brunoosz/Festo2026/README.md

<div align="center">

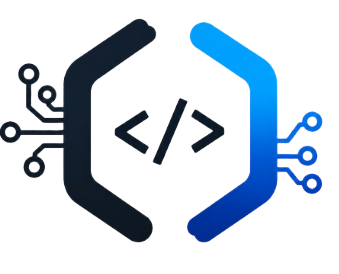
[picture p1: public/logo.png]
Dark Coders


# Flow Pack: Sistema de Controle

Aplicação web para operar e monitorar uma máquina de embalagem Flow Pack em tempo real.






</div>

<p align="center">
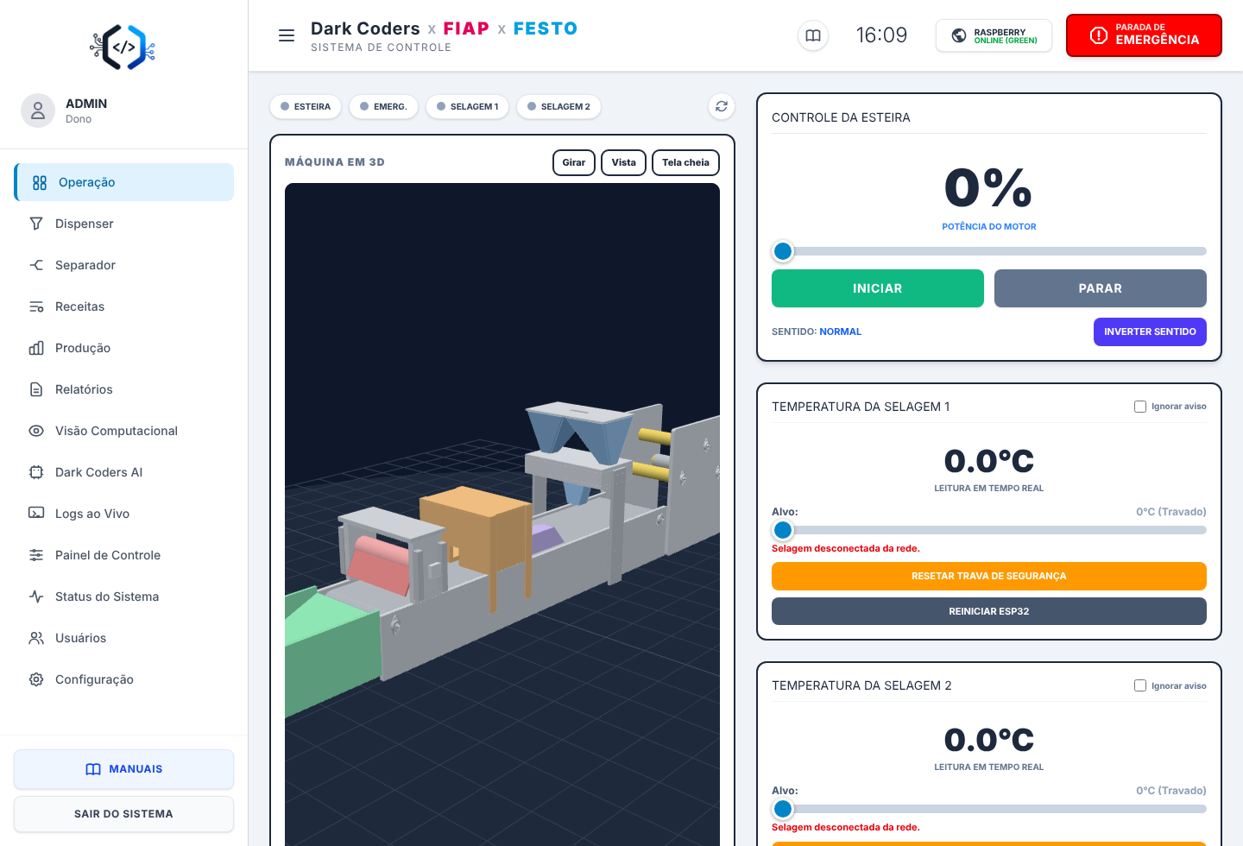
[picture p2: docs/img/dashboard.png]
Tela de operação do sistema
  
</p>

## Visão geral

Projeto da equipe **Dark Coders** (Engenharia da Computação, FIAP) para a **Festo 2026**. O sistema roda em um Raspberry Pi, que se comunica por MQTT com os ESP32 de cada módulo da máquina e entrega uma interface web para operação, acompanhamento da produção e manutenção.

A linha de embalagem é composta por esteira, bobina de filme, dispenser, braço formador, selagem horizontal, selagem final e separador de itens. Cada módulo tem controle individual, indicador de conexão e registro de eventos.

## Funcionalidades

| Módulo | Descrição |
|---|---|
| Operação | Velocidade da esteira, temperatura das selagens, modelo 3D da máquina e LEDs de conexão de **todas as placas** (esteira, selagens, rodinhas, motor, dispenser, servo, câmera e painel NFC). O topo do site mostra sempre a **receita selecionada** (50, 100, 150 ou 200 g). |
| Painel de Controle | Motores e aquecimento de cada selagem, sentido da esteira, reinício e reset de cada placa. Tem também a seção **Separador (servo)**: estado da conexão, teste esquerda/centro/direita, ângulos, velocidade, tempo aberto e liga/desliga do servo (somente Administrador e Dono). |
| Dispenser | Seleção do grão e da quantidade (1/4, 1/2, 3/4 ou 1 volta do rotor) e acionamento da dosagem. |
| Separador | Contagem e reconhecimento de produtos por câmera, com servo que desvia cada item. Inclui treinamento por classe e calibração de fundo, e o **Controle livre do servo** (funciona sem câmera): modo Automático/Manual, ângulo 0–180° ao vivo, esquerda/centro/direita, velocidade, voltar ao centro sozinho, calibração com limites e pulsos, presets, sequências e simulação de detecção. Dono, Adm e Operário comandam; Visualizador só vê. |
| Visão Computacional | Zona de detecção, produtos de referência e confirmação por IA. A câmera mostra o que a IA lê, igual ao Separador: linha de contagem, caixas numeradas (amarela = acompanhando, verde = contada) e nome do produto com a confiança em %. |
| Receitas | Níveis de 50, 100, 150 e 200 g com velocidade e temperatura predefinidas. |
| Produção e Relatórios | Gráficos por hora e por dia e exportação de relatórios em PDF. |
| Dark Coders AI | Assistente com base de conhecimento local e IA online opcional. Aceita comandos por texto e por voz. |
| Alexa | Skill própria: liga com a receita de 50, 100, 150 ou 200 g, aciona a parada de emergência e troca de receita por voz (aumentar, diminuir, escolher e perguntar). |
| Logs ao Vivo | Registro em tempo real de tudo o que acontece, com usuário e origem (site, assistente ou Alexa). |
| Status do Sistema | Internet, Raspberry (temperatura, memória, alimentação) e conexão de cada dispositivo. |
| Usuários | Quatro níveis de acesso e permissão de telas por usuário. |
| Cartões NFC | Cadastro de cartões de Dono/Administrador que liberam a emergência e os botões do painel. |
| Manuais | Manuais em PDF de cada módulo e da máquina completa. |

<p align="center">
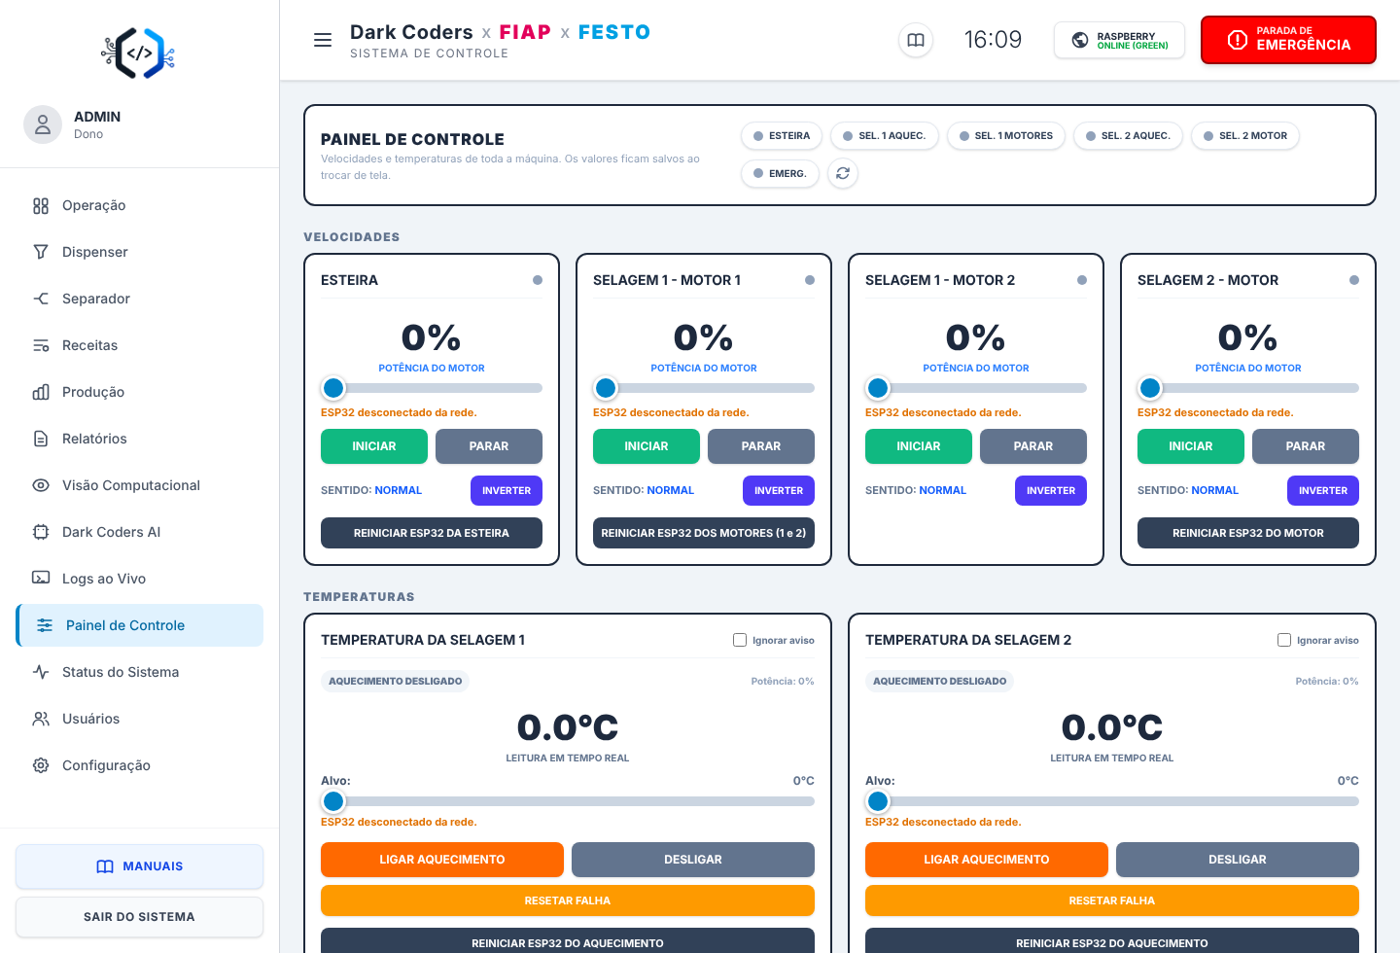
[picture p3: docs/img/painel-controle.png]
Painel de Controle
  
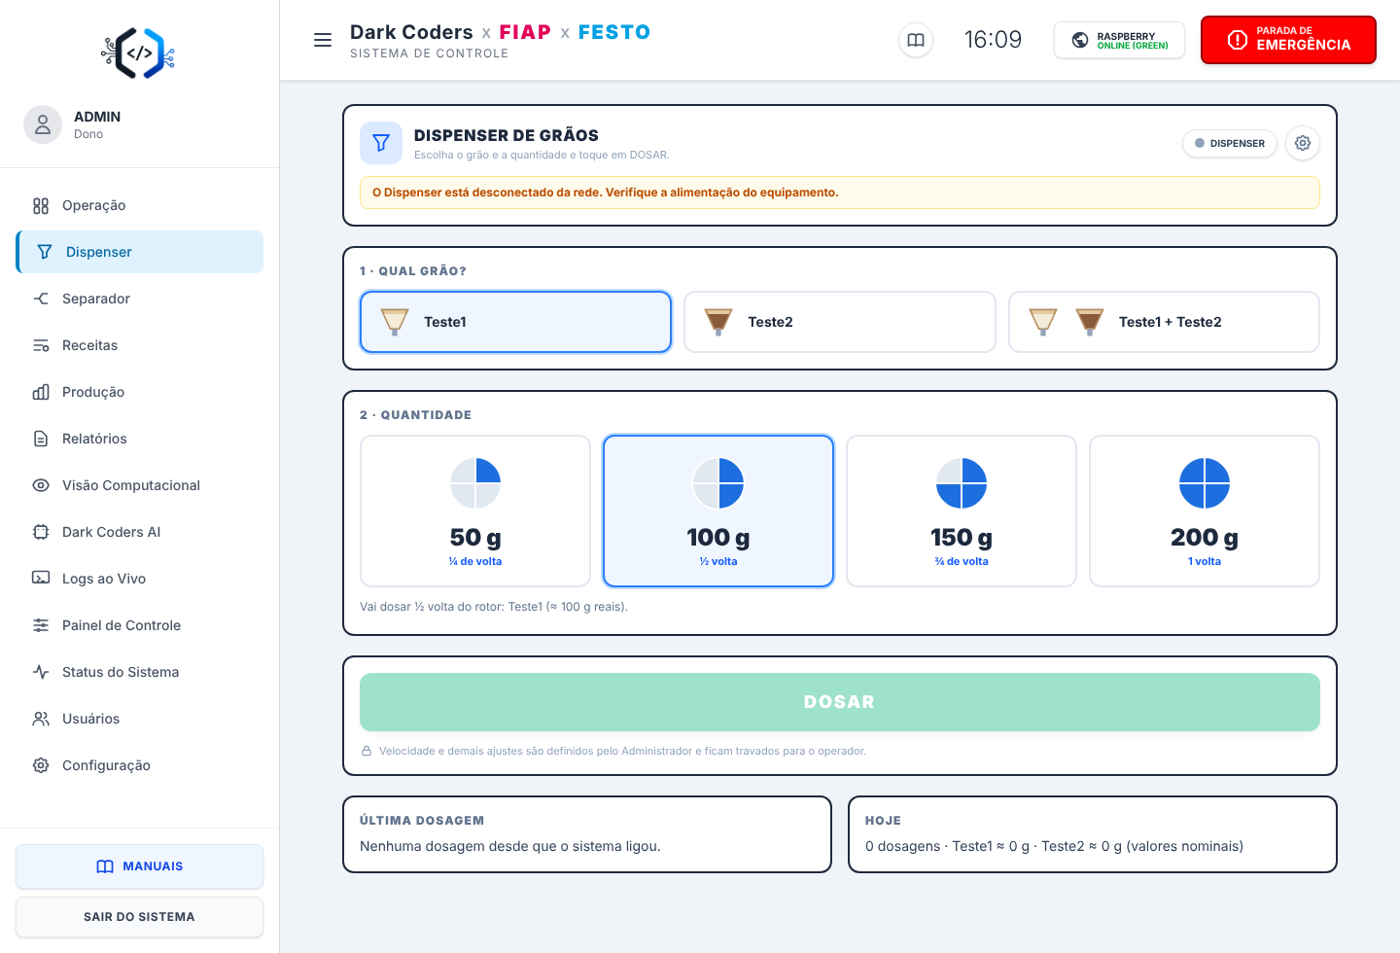
[picture p4: docs/img/dispenser.png]
Dispenser
  
</p>
<p align="center">
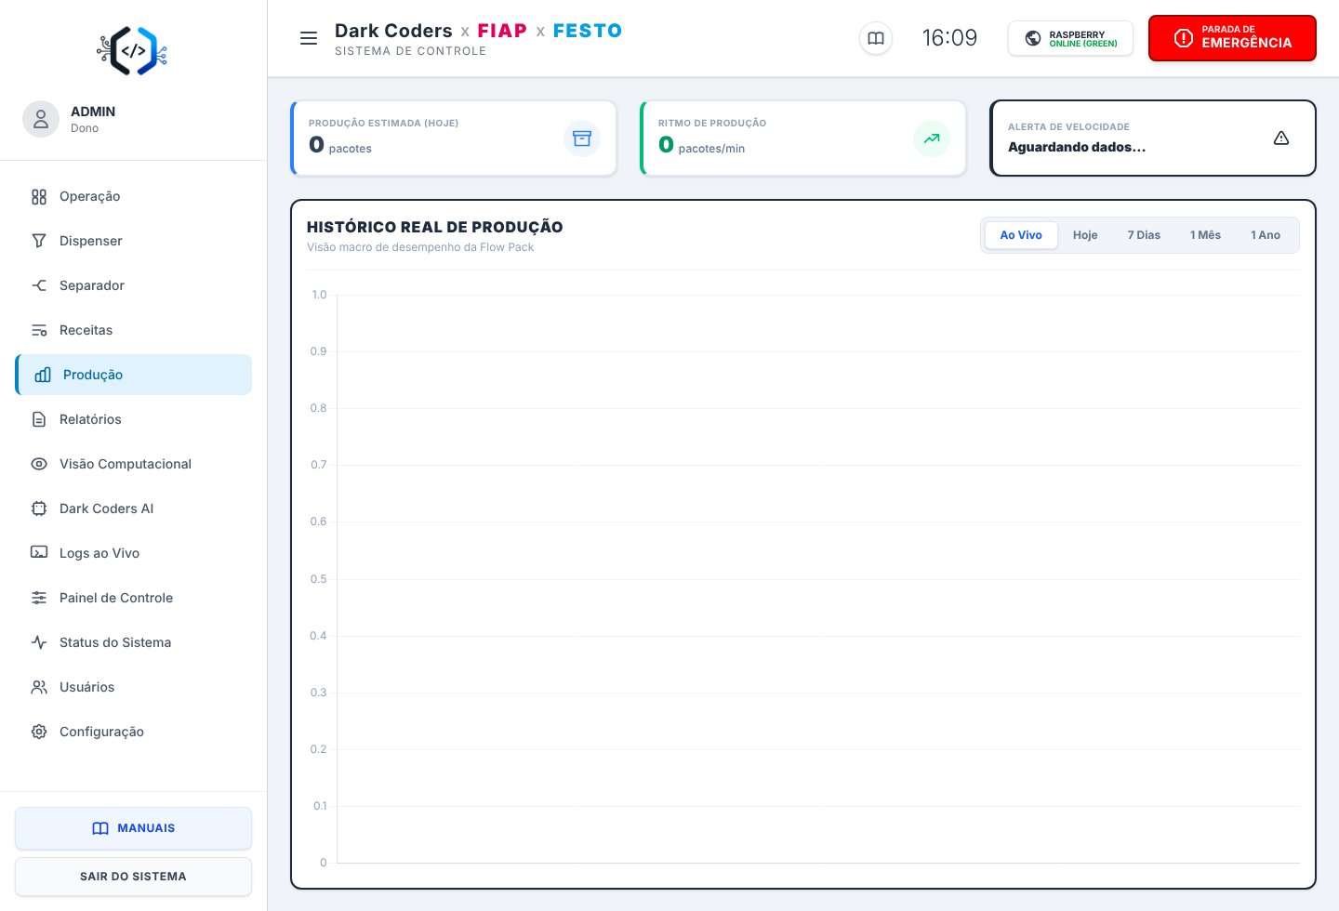
[picture p5: docs/img/producao.png]
Produção
  
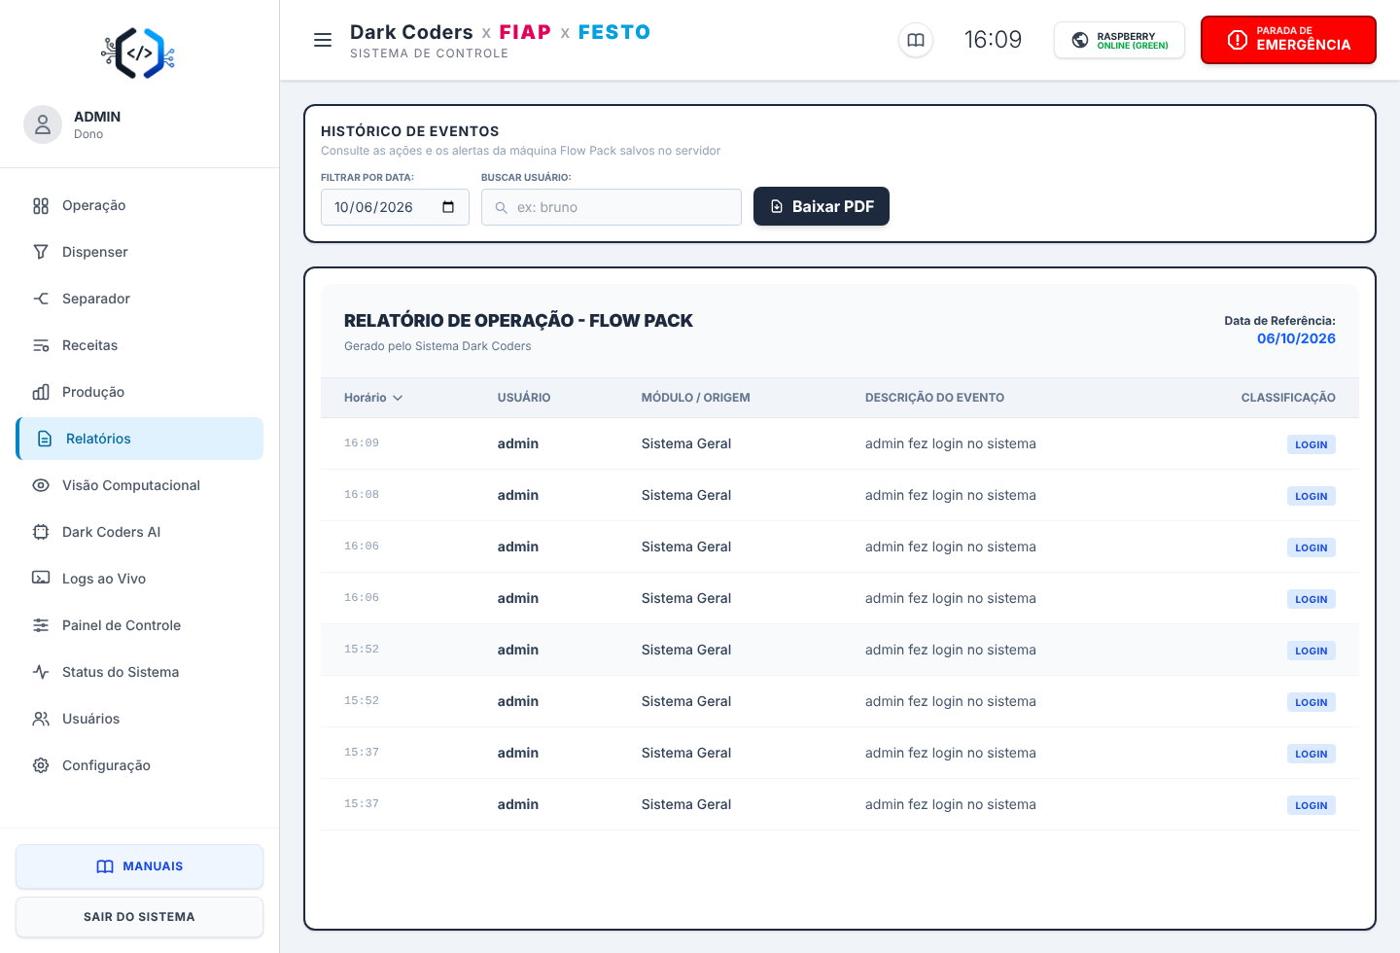
[picture p6: docs/img/relatorios.png]
Relatórios
  
</p>
<p align="center">
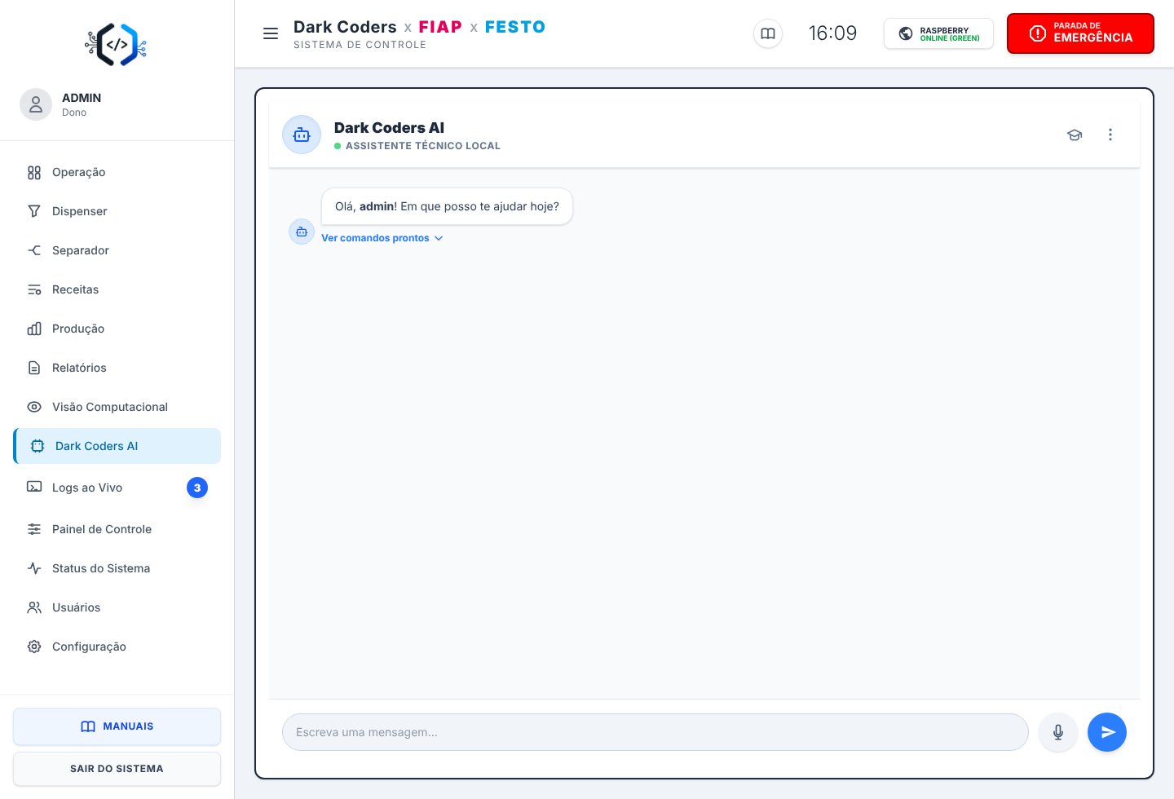
[picture p7: docs/img/chat.png]
Dark Coders AI
  
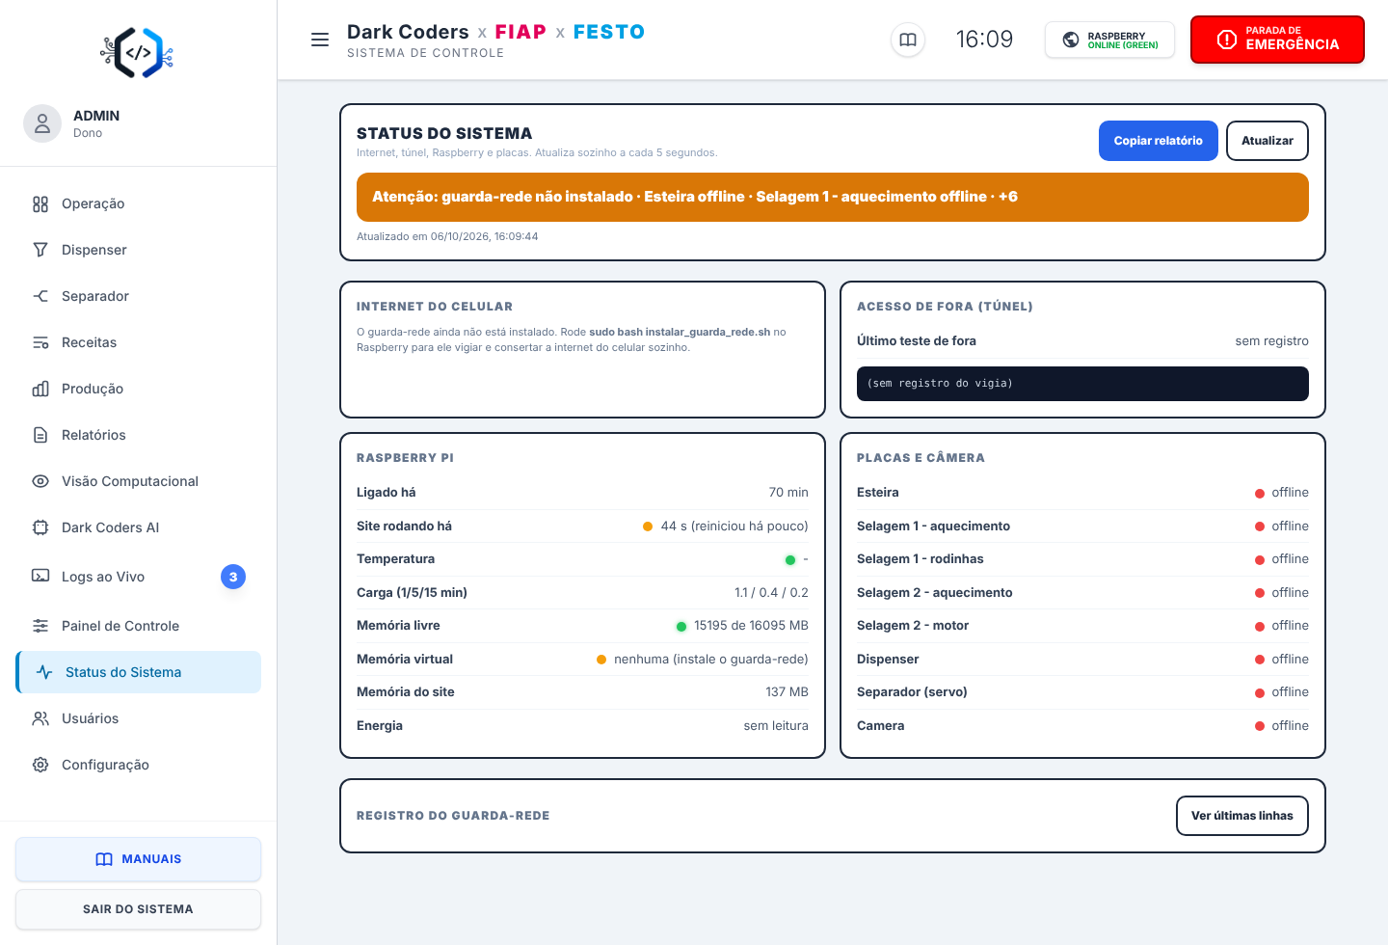
[picture p8: docs/img/status-sistema.png]
Status do Sistema
  
</p>

### Parada de emergência

- O botão fica visível em **todas as telas**, e a emergência também pode vir do botão da esteira, do botão do painel ou da Alexa.
- Depois de acionada, **a máquina inteira fica travada** (esteira, selagens, dispenser, separador, receitas e botões MAIS/MENOS) até um **Dono ou Administrador** liberar.
- Liberar: botão **DESBLOQUEAR** no site (com confirmação) ou **cartão NFC** cadastrado. Depois de liberar, a esteira continua parada.
- A trava vale para todos os aparelhos, continua se o servidor reiniciar. A trava vive só no site: as placas apenas param (a esteira gira ao contrário por 1 s e o servo vai ao centro) e não guardam trava, então liberar no site libera tudo na hora.
- Com a emergência ativa, **todas as telas ganham uma borda vermelha brilhando** (some sozinha ao liberar).

### Cartão NFC e painel físico

Um ESP32 só para o painel (leitor RC522 ou PN532, buzzer, LEDs e 3 botões: EMERGÊNCIA, MAIS e MENOS) manda o número do cartão por MQTT (`nfc/leitura`) e o **servidor decide** (`nfc/resultado`).

- Cartão de **Dono ou Administrador**: libera a emergência (se ativa) e libera **MAIS** e **MENOS** por 30 s, com o LED verde aceso (cada uso renova; variável `NFC_JANELA_MS`).
- A **EMERGÊNCIA** do painel vale sempre, com ou sem cartão. MAIS e MENOS sem cartão não fazem nada (1 bip médio).
- 3 cartões recusados seguidos bloqueiam o leitor por 30 s. Sem Wi-Fi ou site, nada é liberado.
- Só o **Dono** cadastra e apaga cartões, na tela **Cartões NFC** (`/nfc`); a tela mostra só o final de 4 dígitos.
- Desbloquear a emergência pelo site exige Dono ou Administrador.
- Limite: o número do cartão pode ser copiado por cartões "mágicos"; serve ao projeto, não é segurança forte.

Firmwares em [`firmware/`](firmware) e montagem em [`docs/hardware/guia_painel_nfc.txt`](docs/hardware/guia_painel_nfc.txt).

<p align="center">
  Tela Cartões NFC
</p>

### Página pública Sobre nós

[`/sobre`](views/sobre.html) abre **sem login** (botão "i" ao lado de Manuais, item do menu no celular e link na tela de login).

- Menu fixo com as seções: quem somos, o projeto (com galeria), a equipe (cartões com contatos), a jornada e o contato.
- A ordem e a visibilidade das seções e das pessoas vêm dos dados; cada pessoa só mostra e-mail, telefone e links se estiver com "mostrar contatos" ligado e preenchido. Sem foto, aparecem as iniciais.
- O texto original fica em [`data/sobre.json`](data/sobre.json). As alterações salvas ficam em `data/sobre_editado.json` (fora do git, para o `git pull` nunca dar conflito), as fotos em `public/img/equipe/` e `public/img/projeto/`, e os 10 últimos backups em `data/sobre_backups/`. Para voltar a uma versão antiga na mão, copie um backup por cima de `data/sobre_editado.json` e reinicie o site.
- Ícones dos links em SVG local (`sobre_icones.json`) e todo texto escapado na saída.

<p align="center">
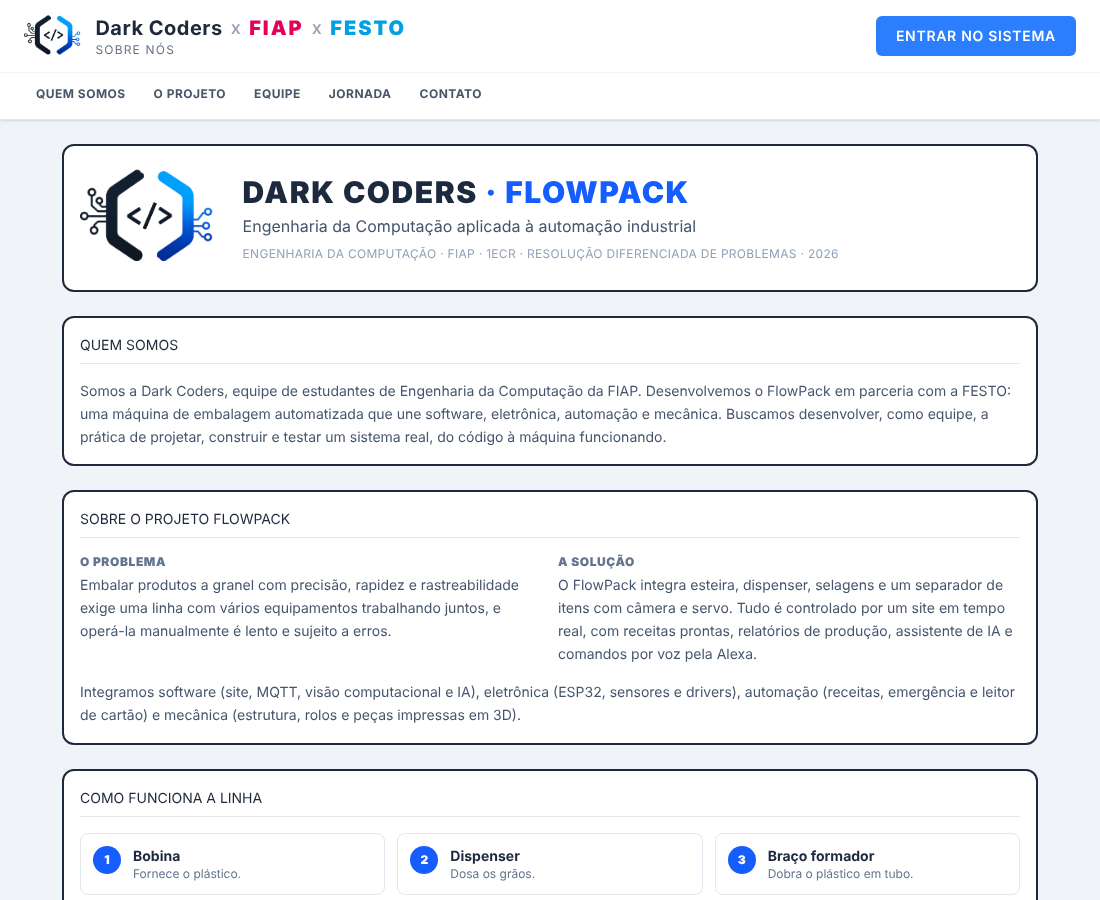
[picture p9: docs/img/sobre.png]
Página Sobre nós
  
</p>

### Modelo 3D

A máquina pode ser visualizada em 3D no próprio site (Dashboard e tela Modelo 3D), com rotação, zoom e modo estrutura. O visualizador usa Three.js com os arquivos servidos localmente, então funciona sem internet. O modelo fica em [`public/modelo/maquina.glb`](public/modelo); para trocá-lo, basta substituir o arquivo.

<p align="center">
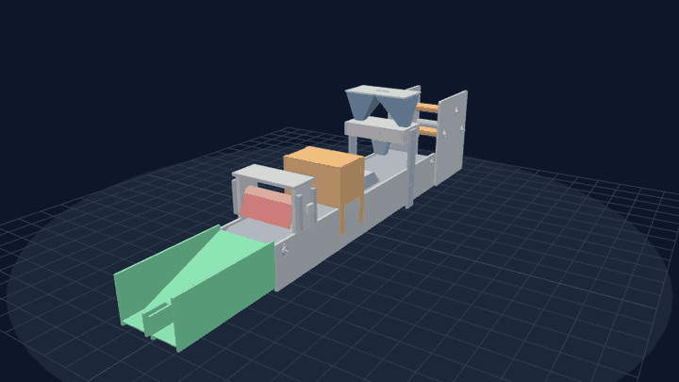
[picture p10: docs/img/modelo-3d.gif]
Modelo 3D da máquina girando
  
</p>

## Arquitetura

<p align="center">
  Diagrama de arquitetura
</p>

- **Back-end:** Node.js, Express 5, Socket.IO e Nunjucks.
- **Front-end:** HTML e JavaScript, Tailwind CSS, Chart.js, jsPDF e Three.js, todos servidos localmente.
- **Mensageria:** MQTT, com o broker Mosquitto no próprio Raspberry.
- **Persistência:** arquivos JSON e a pasta `logs/`. Não há banco de dados, o que mantém o consumo baixo para o Raspberry Pi 3B+.
- **IA:** busca por similaridade na base local (`knowledge/`) e, opcionalmente, modelos da NVIDIA para o chat e a visão.

### Tópicos MQTT

| Módulo | Tópicos |
|---|---|
| Esteira | `esteira/velocidade/set`, `esteira/velocidade/atual`, `esteira/sentido/set`, `esteira/sentido/atual`, `esteira/status`, `esteira/emergencia` |
| Selagem 1 | `selagem/set_temperatura`, `selagem/ativar`, `selagem/dados`, `selagem/status_conexao`, `selagem/emergencia`, `selagem/motores/status` |
| Selagem 2 | `selagem2/set_temperatura`, `selagem2/ativar`, `selagem2/dados`, `selagem2/status_conexao`, `selagem2/emergencia`, `selagem2/motor/status` |
| Dispenser | `dispenser/dosar`, `dispenser/estado`, `dispenser/concluido`, `dispenser/status`, `dispenser/reiniciar`, `dispenser/emergencia` |
| Separador | `separador/desviar`, `separador/config`, `separador/estado`, `separador/status`, `separador/teste`, `separador/emergencia`, `separador/liberar` |
| Emergência e painel | `esteira/botao`, `esteira/estado_emergencia`, `esteira/liberar`, `painel/botao`, `painel/resultado` |
| Cartão NFC | `nfc/leitura`, `nfc/resultado`, `nfc/status`, `nfc/reiniciar` |

## Instalação

### Requisitos

- Node.js 20.6 ou superior
- Broker MQTT acessível (por exemplo, Mosquitto)
- ESP32 dos módulos (opcional para apenas visualizar a interface)

### Passos

```bash
git clone https://github.com/brunoosz/Festo2026.git
cd Festo2026
npm install
cp .env.example .env
npm start
```

A aplicação fica disponível em `http://localhost:5000`. A porta e o endereço do broker podem ser trocados pelas variáveis `PORT` e `MQTT_BROKER` (tabela abaixo).

Na primeira execução, caso não exista `usuarios.json`, é criado o usuário `admin` com senha `admin`. **Altere a senha em Configuração antes de qualquer uso real.**

### Testando no seu computador (preview)

Não precisa do Raspberry nem das placas. Em dois terminais:

```bash
npm install
npm run mock   # broker MQTT de mentira com placas falsas (inclui o servo do separador)
npm run dev    # o site, em http://localhost:5000
```

O `dev` usa a pasta `data-teste/` (nada do `usuarios.json` real é tocado) e cria os logins `dono`, `adm`, `operario` e `visualizador`, todos com a senha `1234`. Para rodar os testes automáticos: `npm test`.

### Testes automáticos

`npm test` sobe o site com um broker MQTT falso e confere, de ponta a ponta: emergência travada, cartão NFC e botões do painel, perfis e permissões (inclusive o Visualizador), servo e visão, Alexa, página Sobre nós, manuais, modelo 3D, receita e LEDs no topo do Dashboard. Os testes ficam em [`tools/testes/`](tools/testes).

### Variáveis de ambiente

| Variável | Descrição | Obrigatória |
|---|---|---|
| `NVIDIA_API_KEY` | Chave da API NVIDIA para o chat e a visão por IA. Sem ela, o chat responde apenas com a base local. | Não |
| `SESSION_SECRET` | Segredo das sessões e dos cookies. Se ausente, é gerado e salvo em `.session_secret`. | Não |
| `MQTT_BROKER` | Endereço do broker MQTT. Padrão: `mqtt://192.168.4.1`. | Não |
| `PORT` | Porta do site. Padrão: `5000`. | Não |
| `NFC_JANELA_MS` | Tempo, em ms, que MAIS e MENOS ficam liberados depois de um cartão. Padrão: `30000` (mantenha igual ao `JANELA_MS` do firmware do painel). | Não |
| `USUARIOS_JSON`, `EMERGENCIA_JSON`, `RECEITAS_JSON`, `CARTOES_NFC_JSON` | Caminho dos arquivos de dados, para testes ou para guardar fora da pasta do site. Padrão: arquivos na pasta do projeto. | Não |

Para que o Node leia o `.env` automaticamente, use `npm run start:env`.

## Implantação no Raspberry Pi

### Atualização

Com o repositório já clonado em `/root/site_esteira` (serviço `site_esteira`), o jeito mais simples é:

```bash
cd /root/site_esteira && git checkout main && git pull
sudo systemctl restart site_esteira
journalctl -u site_esteira -n 30 --no-pager
```

Depois, `Ctrl+Shift+R` no navegador. Rode `npm install` só se o `package.json` tiver mudado. Os firmwares dos ESP32 são gravados pelo Arduino IDE (veja [`firmware/LEIA-ME.md`](firmware/LEIA-ME.md)).

Outra opção é o script abaixo, que também faz backup dos dados.

O script [`atualizar.sh`](atualizar.sh) baixa a versão mais recente do GitHub preservando os dados da máquina: `usuarios.json`, receitas, fotos de referência, configurações, `.env` e logs. Em seguida instala as dependências e reinicia o serviço (pm2 ou systemd).

```bash
cd ~/site_esteira && git fetch origin main && git checkout origin/main -- atualizar.sh && bash atualizar.sh
```

Antes de qualquer alteração, uma cópia dos dados é salva em `../festo2026_backup/`. Para atualizar a partir de outra branch, informe o nome: `bash atualizar.sh nome-da-branch`.

### Acesso externo com Tailscale Funnel

O sistema pode ser acessado fora da rede local por meio do [Tailscale Funnel](https://tailscale.com/kb/1223/funnel), que publica a porta do servidor em um endereço HTTPS:

```bash
sudo tailscale funnel --bg 5000
```

Como a tela de login passa a ficar pública, o servidor aplica as seguintes proteções:

- cookie de "lembrar de mim" assinado, que não pode ser forjado;
- segredo de sessão fora do código-fonte;
- bloqueio por 15 minutos após 8 tentativas de login incorretas a partir do mesmo IP.
- o canal em tempo real (socket) só aceita quem fez login.

Recomendações adicionais estão em [SECURITY.md](SECURITY.md).

## Usuários e permissões

| Nível | Permissões |
|---|---|
| Dono | Acesso total, incluindo promover e apagar usuários. |
| Administrador | Controla a máquina, cria usuários e altera senhas dos níveis abaixo do seu. |
| Operário | Acessa apenas as telas liberadas pelo Dono ou pelo Administrador. |
| Visualizador | Só olha: acompanha em tempo real as telas liberadas e conversa com a IA, mas não controla nada. |

O **Visualizador** é pensado para quem só precisa acompanhar a máquina (professores, visitantes):

- Vê **todas as telas** em modo somente leitura, inclusive Painel de Controle, Status do Sistema, Usuários e Cartões NFC. As telas sensíveis mostram os dados ocultos: sem o final dos cartões, sem linhas de log da rede e só nome e perfil dos usuários.
- Não aciona nada: velocidade, temperatura, receitas, dosagem, servo, ajustes da visão e emergência (o botão fica escondido; aparece só o aviso "Máquina travada"). Também não cria nem altera usuários.
- A IA responde perguntas para ele, mas não executa comandos.
- O Dono cria Visualizadores e escolhe, em **Usuários → Telas**, quais das 12 telas cada um enxerga (por padrão todas).
- O tutorial começa sozinho em **todo** login dele (pular vale só para aquela sessão).
- O bloqueio é feito no servidor (HTTP e socket), não só escondendo botões, e as tentativas bloqueadas ficam nos Logs.

**Tutorial:** o roteiro do tour guiado fica em [`public/js/tutorial-roteiro.js`](public/js/tutorial-roteiro.js) (um passo por item, com a tela, o destaque e o perfil que o vê). Para os demais perfis ele abre na primeira vez, e **Rever tutorial** fica em Configurações e no Chat. A IA usa os textos da pasta `knowledge/` (recarregados sozinhos ao salvar) e conhece o estado ao vivo: emergência, leitor NFC, janela dos botões MAIS/MENOS, receita atual e servo.

Em **Usuários**, o Dono ou o Administrador define, para cada Operário, quais telas ficam disponíveis: Dispenser, Separador, Receitas, Produção, Relatórios, Visão Computacional, Dark Coders AI e Logs. Por padrão, o Operário acessa todas, exceto Receitas. Dashboard e Configuração estão sempre liberados. A restrição é aplicada no menu e no servidor, portanto o acesso direto pela URL também é bloqueado.

<p align="center">
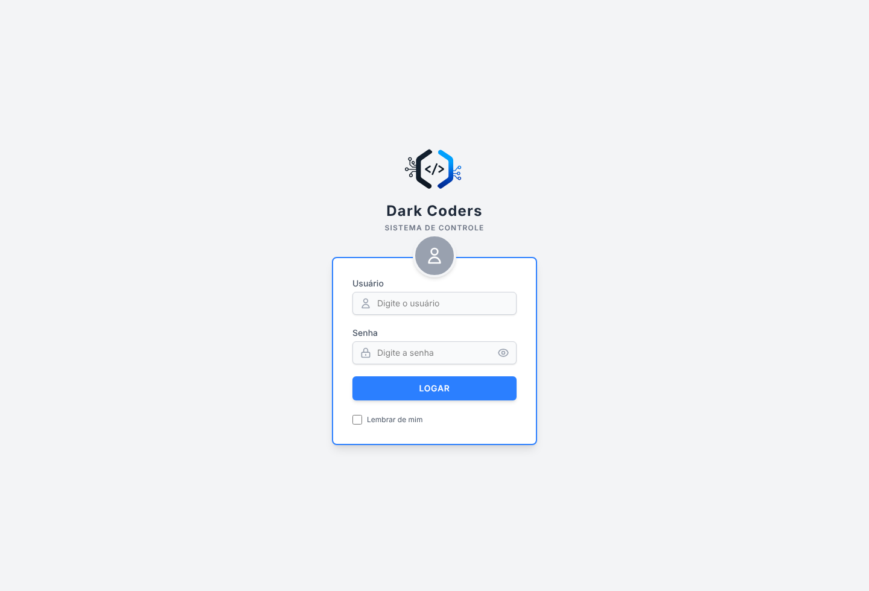
[picture p11: docs/img/login.png]
Tela de login
  
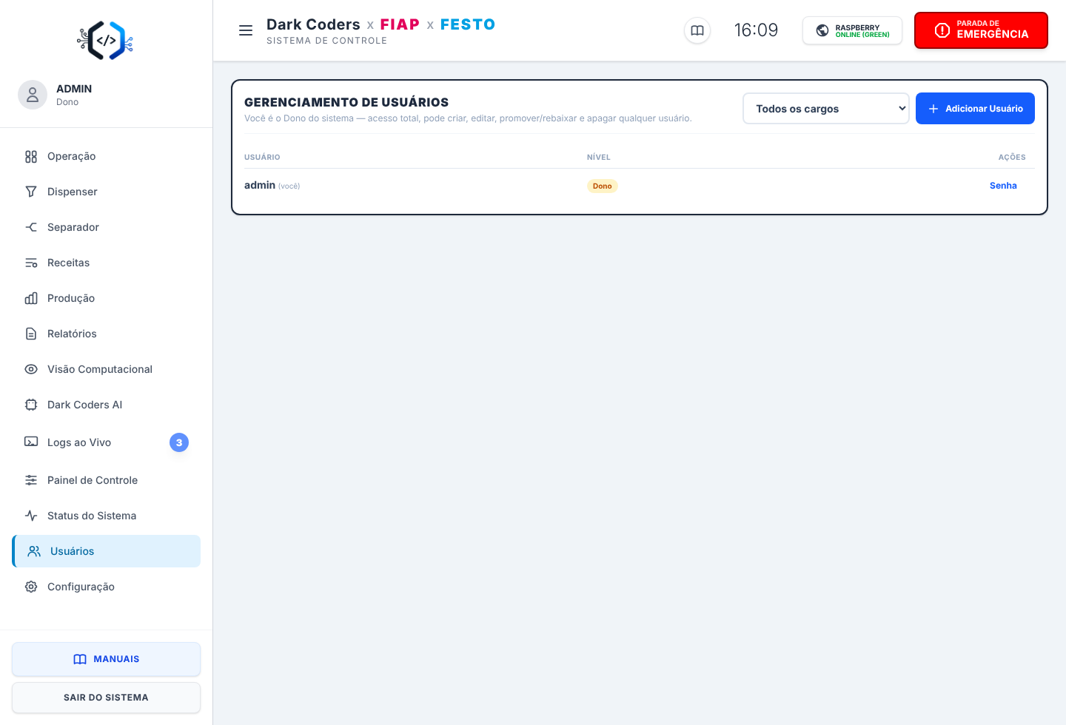
[picture p12: docs/img/usuarios.png]
Gerenciamento de usuários
  
</p>

## Integração com a Alexa

A skill tem os cinco comandos abaixo (depois de cada um ela se fecha sozinha, então é preciso abrir de novo para dar outro) e também troca de receita por voz.

| Você diz | O que acontece |
|---|---|
| "Alexa, abrir controle máquina" (ou "ligar") | A Alexa pergunta com qual pré-definição ligar. |
| "50 gramas" | Aplica a receita de 50 g, liga a esteira, os motores e os dois aquecimentos, e fecha a skill. |
| "100 gramas" | Igual, com a receita de 100 g. |
| "150 gramas" | Igual, com a receita de 150 g. |
| "200 gramas" | Igual, com a receita de 200 g. |
| "emergência" | Aciona a Parada de Emergência em todos os módulos e fecha a skill. |

Receitas por voz, dentro da skill:

| Você diz | O que acontece |
|---|---|
| "aumente a receita" / "diminua a receita" | Sobe ou desce um nível (50 → 100 → 150 → 200 g) e aplica velocidades e temperaturas do nível. |
| "aplique a receita de 100 gramas" | Escolhe o nível. |
| "qual a receita atual" | Diz o nível em uso e o que ele aplica. |

Com a emergência ativa, a Alexa recusa qualquer comando de movimento e explica; ela **nunca libera a emergência** (só Dono ou Administrador, pelo site ou pelo cartão NFC). Opcional: `ALEXA_RECEITA_EXIGE_CARTAO=1` só aceita trocar de receita com a janela do cartão aberta.

Se a máquina estiver travada por uma emergência, a Alexa avisa e não liga nada. As pré-definições são as receitas da tela **Receitas**, então os valores de cada uma (velocidade, motores e temperaturas) são os que estiverem cadastrados lá.

Os pedidos chegam em `POST /alexa`. Antes de executar qualquer comando, o servidor valida a assinatura e o certificado da Amazon e confere o ID da skill. O endereço precisa ser público e usar HTTPS, o que o Tailscale Funnel atende.

O modelo de interação da skill está em [`alexa/modelo_de_interacao.json`](alexa/modelo_de_interacao.json). Para aplicar no console da Alexa, siga o [`alexa/LEIA-ME.md`](alexa/LEIA-ME.md).

## Estrutura do repositório

```
.
├── server.js              Servidor: rotas, MQTT, Socket.IO, Alexa e IA
├── separador_engine.js    Contagem e desvio de produtos do separador
├── sobre_dados.js         Dados da página Sobre nós (validação, versões e backups)
├── sobre_icones.json      Ícones SVG locais dos links
├── atualizar.sh           Atualização do Raspberry Pi
├── alexa/                 Modelo de interação da skill da Alexa
├── firmware/              Códigos dos ESP32 (Arduino IDE)
├── tools/                 Preview local, testes automáticos e instaladores antigos
├── data/                  Texto da página Sobre nós
├── views/                 Telas (templates Nunjucks)
├── public/                Arquivos estáticos, bibliotecas e modelo 3D
├── knowledge/             Base de conhecimento do assistente
├── manuais/               Manuais em PDF
├── docs/img/              Imagens usadas neste README
├── docs/hardware/         Pinagens de cada placa e bibliotecas do Arduino
├── dispenser_config.json  Configuração do dispenser
├── config_visao.json      Configuração da câmera e da visão
└── .env.example           Modelo de variáveis de ambiente
```

## Manuais

Os manuais em PDF ficam em [`manuais/`](manuais) e também podem ser baixados pelo botão **Manuais** do próprio sistema.

| Documento | Arquivo |
|---|---|
| Máquina completa | [`Manual_Maquina_FlowPack.pdf`](manuais/Manual_Maquina_FlowPack.pdf) |
| Esteira | [`Manual_Esteira_FlowPack.pdf`](manuais/Manual_Esteira_FlowPack.pdf) |
| Dispenser | [`Manual_Dispenser_FlowPack.pdf`](manuais/Manual_Dispenser_FlowPack.pdf) |
| Braço formador | [`Manual_BracoFormador_FlowPack.pdf`](manuais/Manual_BracoFormador_FlowPack.pdf) |
| Selagem 1 | [`Manual_Selagem1_FlowPack.pdf`](manuais/Manual_Selagem1_FlowPack.pdf) |
| Selagem 2 | [`Manual_Selagem2_FlowPack.pdf`](manuais/Manual_Selagem2_FlowPack.pdf) |
| Cartão NFC e acesso | [`Manual_NFC_FlowPack.pdf`](manuais/Manual_NFC_FlowPack.pdf) |
| Botões e painel | [`Manual_Botoes_Painel_FlowPack.pdf`](manuais/Manual_Botoes_Painel_FlowPack.pdf) |
| Alexa (comandos de voz) | [`Manual_Alexa_FlowPack.pdf`](manuais/Manual_Alexa_FlowPack.pdf) |

**Como adicionar um manual:** copie o PDF para a pasta `manuais/` com o nome exato acima. Ele passa a abrir sozinho, sem reiniciar o site (a existência do arquivo é conferida a cada acesso).
Para um manual novo, acrescente uma linha na lista `LISTA_MANUAIS` do `server.js` (id, título, arquivo e descrição).

## Contribuição

Consulte [CONTRIBUTING.md](CONTRIBUTING.md) antes de abrir um pull request.

## Licença

Distribuído sob a licença MIT. Consulte o arquivo [LICENSE](LICENSE).
