brunoosz/Festo2026/docs/hardware/pinagens/01_pinagem_esteira.txt

PINAGEM - ESP32 DA ESTEIRA (ESP32 DEVKIT V1)   [versao com o painel NFC]
Placa no Arduino IDE: ESP32 Dev Module
=====================================================

DRIVER BTS7960 (IBT-2)     ESP32
-----------------------------------
RPWM                       GPIO 25
LPWM                       GPIO 26
R_EN + L_EN (juntos)       GPIO 27
VCC                        3.3V
GND                        GND

POTENCIA DO BTS7960
-----------------------------------
B+                         fusivel -> + da fonte do motor (24 V)
B-                         - da fonte do motor
M+ / M-                    fios do motor
O GND da fonte, do driver e do ESP32 precisam estar juntos.

BOTAO DE EMERGENCIA (um fio no pino, o outro no GND)
-----------------------------------
EMERGENCIA                 GPIO 32  <->  GND
(MAIS e MENOS NAO ficam mais aqui: foram para o ESP32 do painel, que so aceita com cartao NFC.)
Este botao para a esteira NA HORA, mesmo sem Wi-Fi, e a esteira fica travada ate liberar (site ou cartao).

PARA O BOTAO NAO DISPARAR SOZINHO (recomendado)
-----------------------------------
1) Resistor de 10 kOhm entre o pino do botao e o 3V3 (pull-up externo).
2) Capacitor ceramico de 100 nF (104) em paralelo com o botao.
3) Fios trancados ou blindados, longe dos fios do motor e do BTS7960.
4) Fio curto e bem preso.
O codigo ja ignora picos de ruido, os 3 s depois de ligar e botao "preso". O Monitor Serial mostra a origem:
   ">>> BOTAO: emergencia (apertado ha X ms)"  = veio do botao | ">>> EMERGENCIA (SITE)" = veio do site/Alexa/painel

ALIMENTACAO DO ESP32
-----------------------------------
5 V do regulador no pino VIN (nunca a fonte de 24 V direto). Para gravar pelo USB, tire o fio de 5 V do VIN.

TESTE (Monitor Serial 115200, "Nova linha")
-----------------------------------
STATUS (botao de emergencia e trava) | V=60 | INVERTER | EMERGENCIA
