brunoosz/Festo2026/public/maquina.png

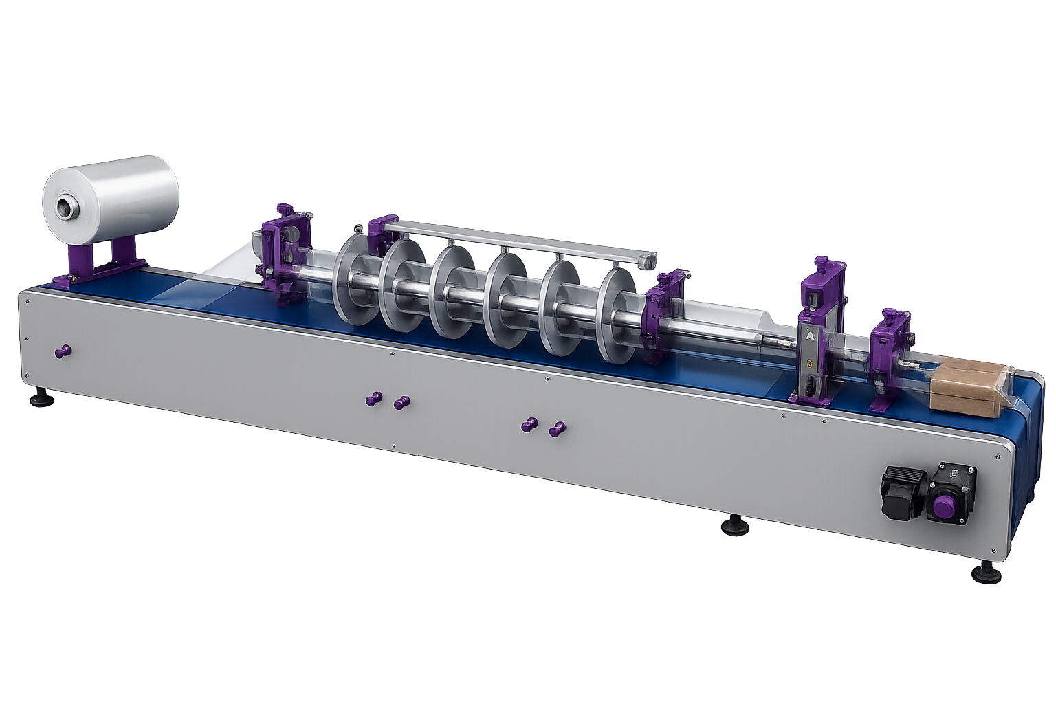
public/maquina.png
