brunoosz/Festo2026/(commit log)

2026-10-06 DarkCoders site Festo 2026
    [motor.json]
2026-10-06 feat: modelo 3D no slot lateral do dashboard e permissoes de telas por usuario
    Move o card 3D para a area ao lado dos controles. Operarios nao veem Receitas por padrao e o Dono/Admin libera telas por usuario em Usuarios > Telas (menu e rotas). Adiciona chokidar, exigido pelo nunjucks watch.
2026-10-06 chore: comentarios mais simples, favicon, sessao segura, limite de login e script de atualizacao
2026-10-06 docs: funnel do tailscale e atualizacao do raspberry
2026-10-06 feat: novo modelo 3D (dispenser do CAD, braco formador, bobina no chao, laterais cinza) e fundo escuro com chao
    Claude-Session: https://claude.ai/code/session_015jzdfWxrstErNGMTfszucj
2026-10-06 feat: esteira toda cinza, cores mais claras e luz de cima no modelo 3D
    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
2026-10-06 feat: selagem final no fim da esteira (laterais de madeira, mancais e rolo)
    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
2026-10-06 chore: icones de usuarios e emergencia, manual atualizado, README com prints e SECURITY ajustado
    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
2026-10-06 docs: README profissional com diagrama de arquitetura, GIF do modelo 3D e topicos MQTT
    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
2026-10-06 docs: manuais com prints do sistema e imagens do modelo 3D nos espacos de foto, avisos atualizados
    Tambem permite trocar o broker MQTT pela variavel MQTT_BROKER (padrao igual ao anterior).
    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
2026-10-06 feat: skill da Alexa com 5 comandos (receitas de 50/100/150/200 g e emergencia), modelo de interacao e docs
    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
2026-10-20 Firmwares dos ESP32 (com a Fase 4), pinagens e instaladores antigos
    A senha do Wi-Fi nao vai para o repositorio: nos firmwares ela foi trocada por COLOQUE_A_SENHA_DO_WIFI.
    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
2026-10-20 Fase 4: emergencia travada ate liberar no site
    Depois de uma emergencia (botao fisico, site ou Alexa) o servidor bloqueia os comandos de movimento
    ate alguem clicar em DESBLOQUEAR. O estado fica em emergencia_estado.json e sobrevive ao reinicio.
    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
2026-10-20 Pagina publica Sobre nos (sem login) e link na tela de login
    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
2026-10-20 Preview local, testes automaticos e README
    Variaveis PORT, USUARIOS_JSON, EMERGENCIA_JSON e RECEITAS_JSON, scripts npm run dev/mock/seed/test
    e usuarios de teste que nao tocam o usuarios.json real.
    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
2026-10-20 Perfil Visualizador (nivel 4): trava no servidor e telas liberaveis
    O Visualizador le tudo o que foi liberado e nao controla nada. A trava fica no servidor:
    so GET passa (mais conversar com a IA e preferencias da conta), eventos de socket de controle
    sao descartados e as tentativas ficam nos Logs. O Dono escolhe as telas de cada Visualizador.
    O socket tambem passa a recusar quem nao fez login.
    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
2026-10-20 Visualizador: modo somente leitura nas telas e Usuarios com escolha de telas
    Controles ficam apagados e travados, o botao de emergencia some (aparece o aviso Maquina travada),
    a IA nao executa comandos de velocidade/temperatura e o modal Telas serve tambem para Visualizador.
    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
2026-10-20 Painel de Controle: seção do servo do separador (teste, ângulos, velocidade, ligar/desligar)
    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
2026-10-21 Corrige logs de emergência e NFC salvos como texto, que quebravam a tela Relatórios
    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
2026-10-22 NFC: usuário logado aparece primeiro e já selecionado na lista de cadastro
    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
2026-10-22 Manuais: entradas de Alexa, Cartão NFC e Botões/painel (PDF aparece sozinho ao copiar o arquivo)
    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
2026-10-22 Modelo 3D: enquadramento pela esfera, Vista que para o giro e tela cheia com barra de controles (inclui iPhone)
    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
2026-10-22 Ignora a pasta entregas (arquivos gerados para envio)
    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
2026-10-22 Teste da moldura vermelha da emergência
    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
2026-10-22 IA: base de conhecimento, prompt e estado ao vivo atualizados (emergência, NFC, painel, perfis)
    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
2026-10-22 Topo do site: botão Sobre nós ao lado de Manuais e receita selecionada (50, 100, 150 ou 200 g) sempre visível
    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
2026-10-22 Menu lateral volta a ter só o botão Manuais (Sobre nós fica apenas no topo)
    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
2026-10-22 Dashboard: LEDs de todas as placas, em fila compacta (2 linhas no computador, 3 no celular)
    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
2026-10-22 Manuais do Cartão NFC e dos Botões e painel adicionados (sem o espaço de foto do painel, que não existe ainda)
    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
2026-10-22 README reorganizado: emergência, NFC e Sobre nós em seções curtas, tópicos MQTT e variáveis completos, testes, prints novos (dashboard, NFC e Sobre nós)
    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
2026-10-22 Comentários curtos em todo o código e link do GitHub/LinkedIn na primeira linha de cada arquivo
    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
2026-10-23 Emergência: causa raiz da reativação sozinha, origem nos logs, liberação confirmada e indicador único (#20)
    - servidor nunca liga a emergência a partir do estado reportado pela placa
    - liberação reenviada até as placas confirmarem, com janela que ignora eco
    - toda ativação e liberação registra a origem em Logs ao Vivo e journalctl
    - esteira confirma liberação mesmo já livre (precisa regravar a esteira)
    - tela: uma função só (aplicarEstadoEmergencia) alimentada por /api/emergencia, socket e reconexão, sem atualização otimista
    - testes: 100 ciclos (cartão e site) e tela com Playwright
    Co-authored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
2026-10-23 Servo do separador livre: modo manual, controles diretos, calibração, presets, sequências e simulação (#21)
    - novas rotas /api/separador/servo/* (Dono, Adm e Operário; Visualizador só vê; 423 na emergência)
    - firmware: tópicos separador/servo/angulo, config e parar, limites, pulsos e inversão
    - firmware: passa a assinar separador/liberar (antes nunca destravava)
    - painel 'Controle livre do servo' em /separador, sem depender da câmera
    - teste automático servo_livre.js e mock com os novos tópicos
    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
2026-10-23 Manual da Alexa (PDF) completo e cadastrado na tela de Manuais (#23)
    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
2026-10-23 Lote 4 – Etapa 3: menu lateral com sanduíche animado e modo só ícones (#22)
    * Menu lateral: sanduíche animado e modo só ícones
    - botão com tracinhos que viram X (220 ms), aria-expanded e aria-label
    - menu recolhido vira faixa de 64 px só com ícones e dica com o nome
    - conteúdo se ajusta sem pulo; escolha lembrada por aparelho
    - Esc fecha a gaveta no celular; respeita 'reduzir movimento'
    - teste automático menu_lateral.js
    * Teste do servo: espera maior pela placa offline
    Claude-Session: http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
2026-10-23 Trava de emergência só no site: placas apenas param e não guardam trava (#24)
    - servidor deixa de mandar separador/emergencia; servo só vai ao centro
    - liberar no site é imediato, sem esperar confirmação das placas
    - esteira e separador: sem trava gravada (apagam a trava de versões antigas)
    - site publica esteira/estado_emergencia (LED do painel NFC)
    - testes ajustados; teste do manual não apaga mais o PDF real
    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
2026-10-23 Alexa: aceita a cadeia atual de certificados da Amazon e baixa o certificado de novo quando o guardado está velho
    - a verificação exigia que o último certificado da cadeia fosse de uma raiz confiável; a Amazon manda um certificado cruzado Starfield no fim que o Node não reconhece, e todo pedido era recusado (a Alexa dizia 'problema com a resposta da skill')
    - certificado velho guardado em alexa_cert_cache.json nunca era trocado; agora baixa de novo uma vez e tenta outra vez
    - novo teste alexa_certificado.js com a cadeia real da Amazon
    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
2026-10-23 Alexa: aceita a cadeia atual de certificados da Amazon e baixa o certificado de novo quando o guardado está velho (#25)
    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
2026-10-23 Guardião do Tailscale Funnel: instalador, diagnóstico e guia para o Raspberry (#26)
    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
2026-10-24 Selagem 2: firmware v3 (barra quente) e ajuste fino no site
    - firmware 03 v3, pinagem e guia da barra quente no repositório
    - alarmes novos em português claro (cor, Logs ao Vivo só quando muda); aviso amarelo não trava o controle
    - Painel de Controle: autotune, ganhos PID, calibração, leitura bruta e gráfico dos últimos 10 min
    - rotas /api/selagem2/{autotune,pid,calibrar} só Dono/Adm, validadas, 423 na emergência, log de quem fez
    - emergência cancela o autotune; mock e testes automáticos
    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
2026-10-24 Firmware do separador: teste do servo ao ligar, comandos TESTE e ANG=, buffer MQTT maior e log dos comandos (#30)
    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
2026-10-24 Emergência: apertos repetidos com a emergência ativa não mandam parar de novo às placas (#31)
    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
